indrekluuk/RobotexLineFollowerCamera/doc/IMG_1522.jpg

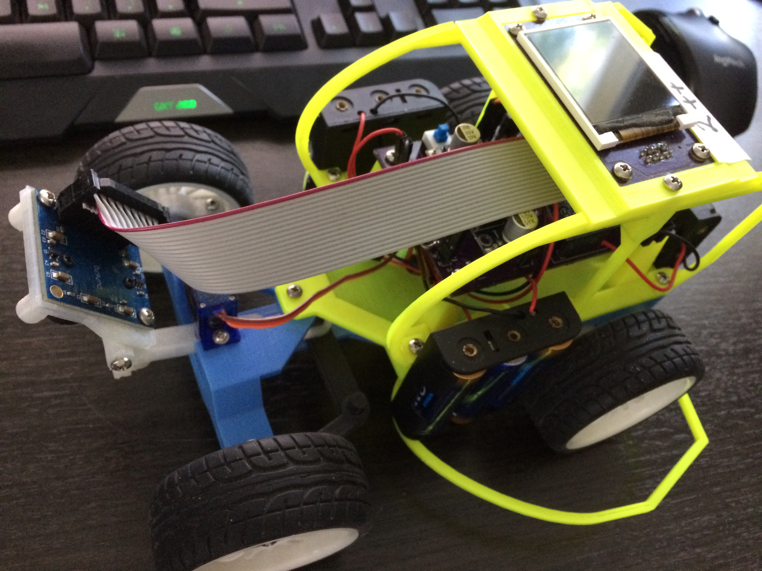
doc/IMG_1522.jpg
