indrekluuk/RobotexLineFollowerCamera/pcb/CameraBoard/Drill.png

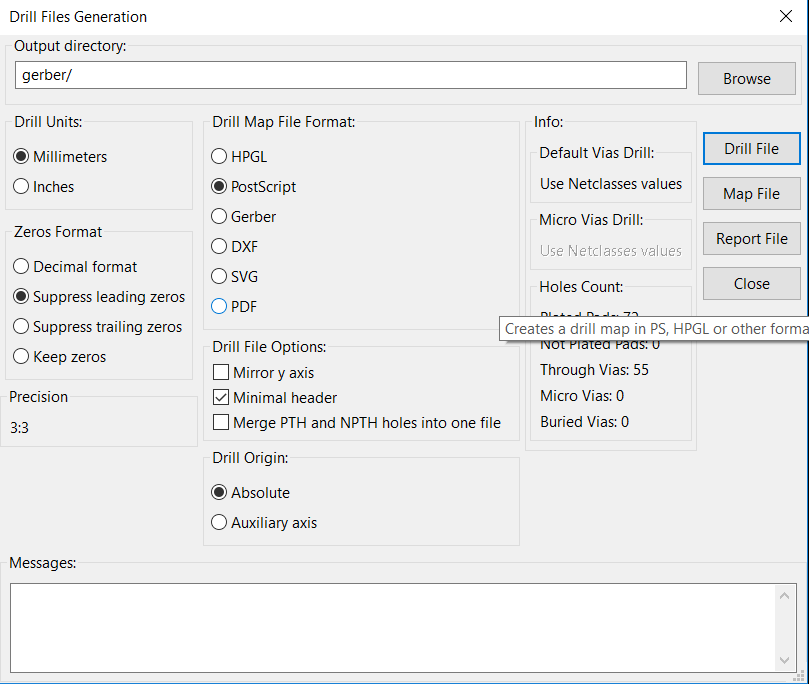
pcb/CameraBoard/Drill.png
