indrekluuk/RobotexLineFollowerCamera/pcb/CameraBoard/Plot.png

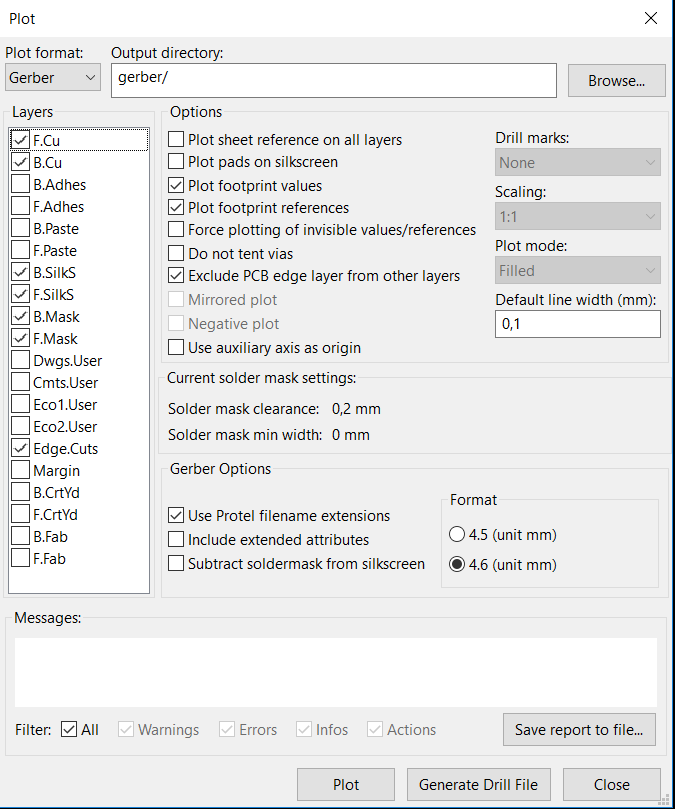
pcb/CameraBoard/Plot.png
