indrekluuk/RobotexLineFollowerCamera/pcb/CameraBoard/CameraBoard.kicad_pcb

## KiCad design pcb/CameraBoard/CameraBoard.kicad_pcb (2016-10-03)

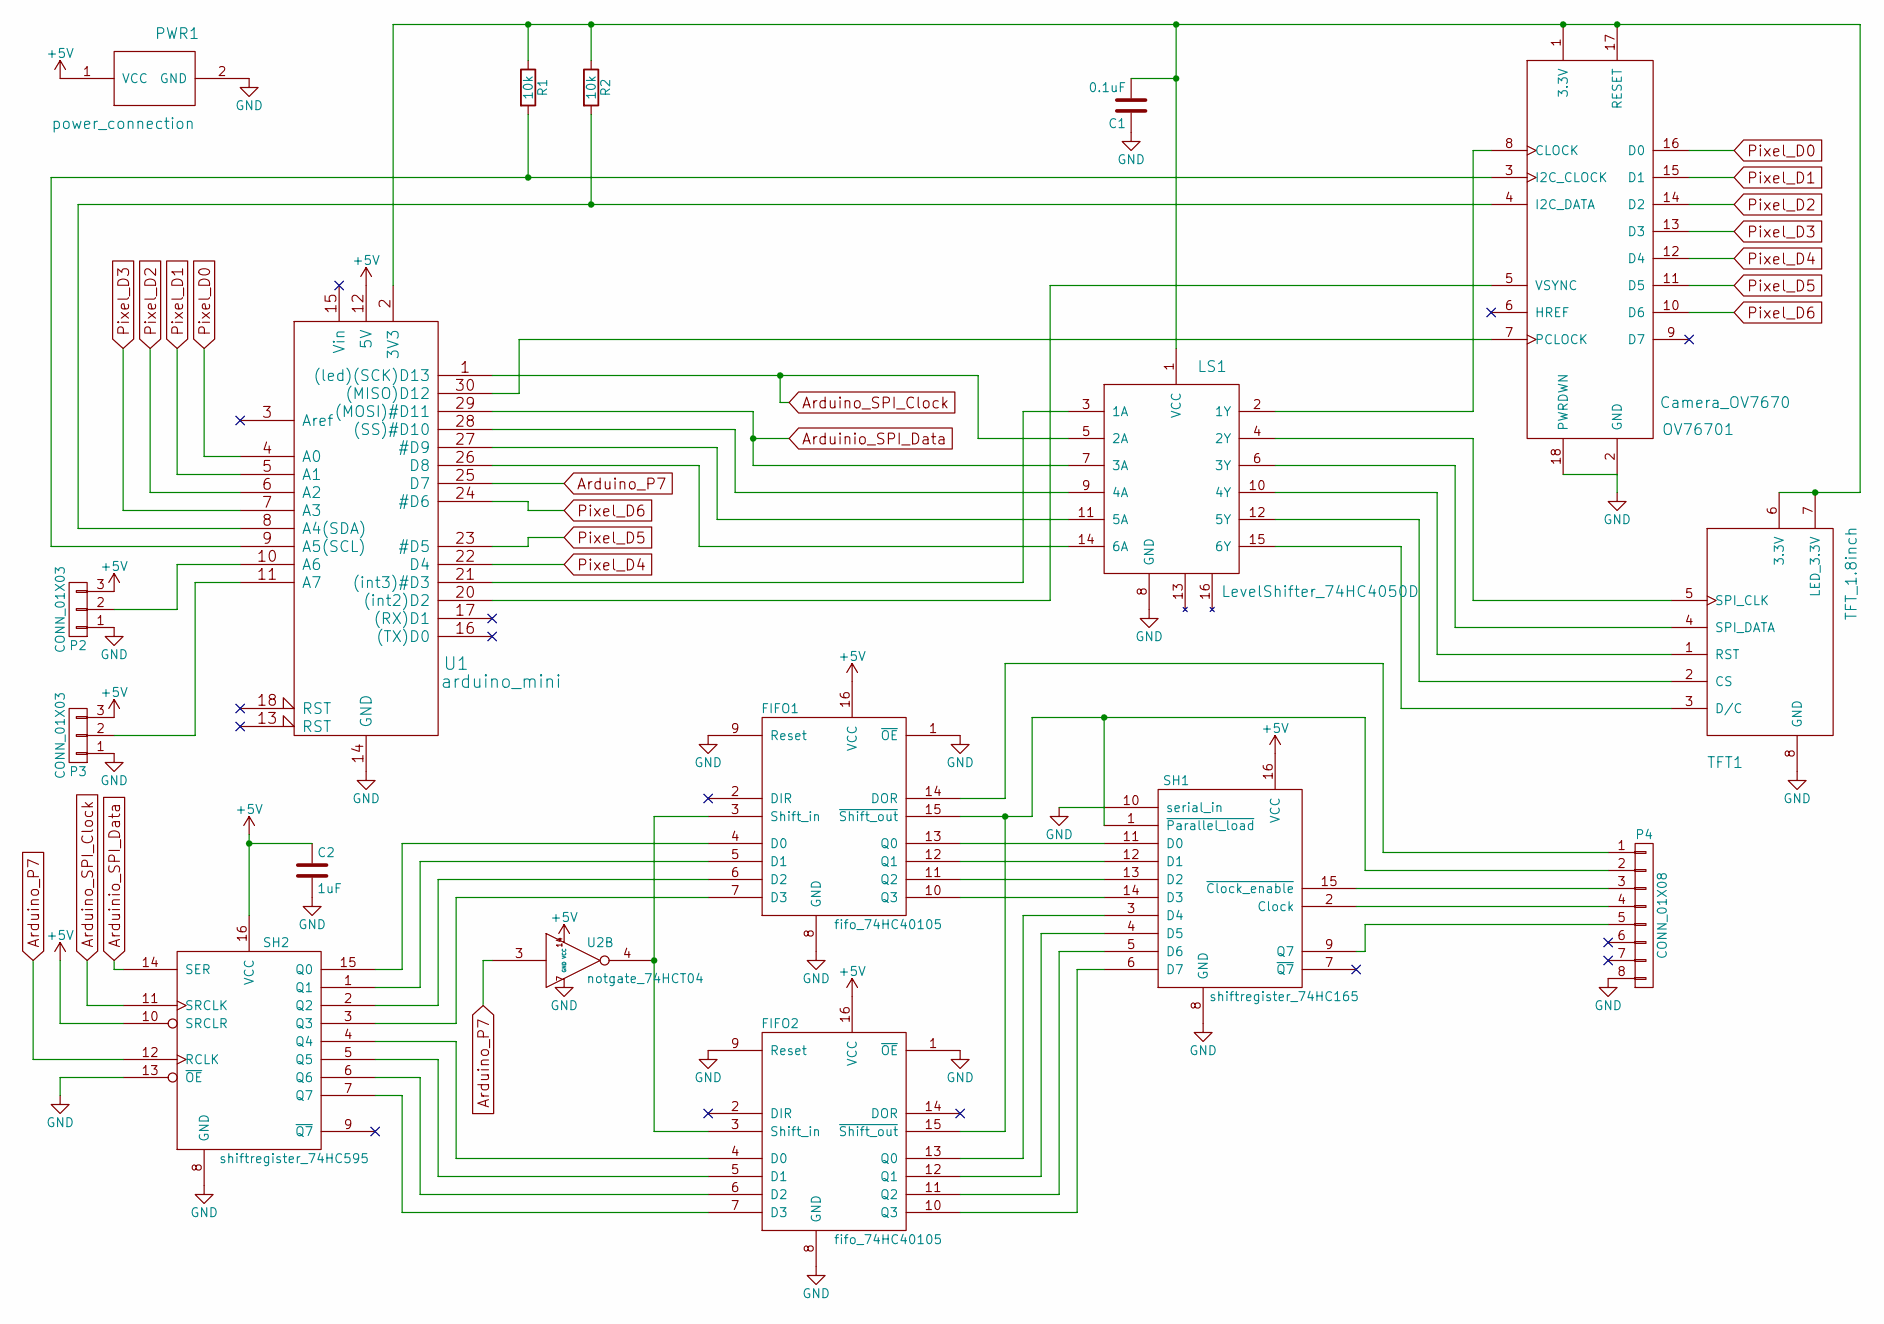
[picture p4: schematic CameraBoard.sch]

Parts:
C1: 0.1uF; C_1206_HandSoldering
C2: 1uF; C_1206_HandSoldering
FIFO1, FIFO2: fifo_74HC40105; SOIC-16_3.9x9.9mm_Pitch1.27mm
LS1: LevelShifter_74HC4050D; SOIC-16_3.9x9.9mm_Pitch1.27mm
OV76701: Camera_OV7670; Pin_Header_Straight_2x09
P2, P3: CONN_01X03; Pin_Header_Straight_1x03
P4: CONN_01X08; Pin_Header_Straight_2x04
PWR1: power_connection; Pin_Header_Straight_1x02
R1, R2: 10k; R_1206_HandSoldering
SH1: shiftregister_74HC165; SOIC-16_3.9x9.9mm_Pitch1.27mm
SH2: shiftregister_74HC595; SOIC-16_3.9x9.9mm_Pitch1.27mm
TFT1: TFT_1.8inch; Pin_Header_Straight_2x04
U1: arduino_mini
U2: notgate_74HCT04; SOIC-14_3.9x8.7mm_Pitch1.27mm

Connections:
+5V: C2.1, FIFO1.16 (VCC), FIFO2.16 (VCC), P2.3, P3.3, PWR1.1 (VCC), SH1.16 (VCC), SH2.10 (SRCLR), SH2.16 (VCC), U1.12 (5V), U2.14 (VCC)
Arduinio_SPI_Data: LS1.7 (3A), SH2.14 (SER), U1.29 ((MOSI)#D11)
Arduino_P7: SH2.12 (RCLK), U1.25 (D7), U2.3
Arduino_SPI_Clock: LS1.5 (2A), SH2.11 (SRCLK), U1.1 ((led)(SCK)D13)
GND: C1.1, C2.2, FIFO1.1 (~OE), FIFO1.8 (GND), FIFO1.9 (Reset), FIFO2.1 (~OE), FIFO2.8 (GND), FIFO2.9 (Reset), LS1.8 (GND), OV76701.2 (GND), OV76701.18 (PWRDWN), P2.1, P3.1, P4.8, PWR1.2 (GND), SH1.8 (GND), SH1.10 (serial_in), SH2.8 (GND), SH2.13 (~OE), TFT1.8 (GND), U1.14 (GND), U1.19 (GND), U2.7 (GND)
unnamed: C1.2, LS1.1 (VCC), OV76701.1 (3.3V), OV76701.17 (RESET), R1.1, R2.1, TFT1.6 (3.3V), TFT1.7 (LED_3.3V), U1.2 (3V3)
unnamed: FIFO1.3 (Shift_in), FIFO2.3 (Shift_in), U2.4
unnamed: FIFO1.4 (D0), SH2.15 (Q0)
unnamed: FIFO1.5 (D1), SH2.1 (Q1)
unnamed: FIFO1.6 (D2), SH2.2 (Q2)
unnamed: FIFO1.7 (D3), SH2.3 (Q3)
unnamed: FIFO1.10 (Q3), SH1.14 (D3)
unnamed: FIFO1.11 (Q2), SH1.13 (D2)
unnamed: FIFO1.12 (Q1), SH1.12 (D1)
unnamed: FIFO1.13 (Q0), SH1.11 (D0)
unnamed: FIFO1.14 (DOR), P4.1
unnamed: FIFO1.15 (~Shift_out), FIFO2.15 (~Shift_out), P4.2, SH1.1 (~Parallel_load)
unnamed: FIFO2.4 (D0), SH2.4 (Q4)
unnamed: FIFO2.5 (D1), SH2.5 (Q5)
unnamed: FIFO2.6 (D2), SH2.6 (Q6)
unnamed: FIFO2.7 (D3), SH2.7 (Q7)
unnamed: FIFO2.10 (Q3), SH1.6 (D7)
unnamed: FIFO2.11 (Q2), SH1.5 (D6)
unnamed: FIFO2.12 (Q1), SH1.4 (D5)
unnamed: FIFO2.13 (Q0), SH1.3 (D4)
unnamed: LS1.2 (1Y), OV76701.8 (CLOCK)
unnamed: LS1.3 (1A), U1.21 ((int3)#D3)
unnamed: LS1.4 (2Y), TFT1.5 (SPI_CLK)
unnamed: LS1.6 (3Y), TFT1.4 (SPI_DATA)
unnamed: LS1.9 (4A), U1.28 ((SS)#D10)
unnamed: LS1.10 (4Y), TFT1.1 (RST)
unnamed: LS1.11 (5A), U1.27 (#D9)
unnamed: LS1.12 (5Y), TFT1.2 (CS)
unnamed: LS1.14 (6A), U1.26 (D8)
unnamed: LS1.15 (6Y), TFT1.3 (D/C)
unnamed: OV76701.3 (I2C_CLOCK), R1.2, U1.9 (A5(SCL))
unnamed: OV76701.4 (I2C_DATA), R2.2, U1.8 (A4(SDA))
unnamed: OV76701.5 (VSYNC), U1.20 ((int2)D2)
unnamed: OV76701.7 (PCLOCK), U1.30 ((MISO)D12)
unnamed: P2.2, U1.10 (A6)
unnamed: P3.2, U1.11 (A7)
unnamed: P4.3, SH1.15 (~Clock_enable)
unnamed: P4.4, SH1.2 (Clock)
unnamed: P4.5, SH1.9 (Q7)
Pixel_D0: OV76701.16 (D0), U1.4 (A0)
Pixel_D1: OV76701.15 (D1), U1.5 (A1)
Pixel_D2: OV76701.14 (D2), U1.6 (A2)
Pixel_D3: OV76701.13 (D3), U1.7 (A3)
Pixel_D4: OV76701.12 (D4), U1.22 (D4)
Pixel_D5: OV76701.11 (D5), U1.23 (#D5)
Pixel_D6: OV76701.10 (D6), U1.24 (#D6)

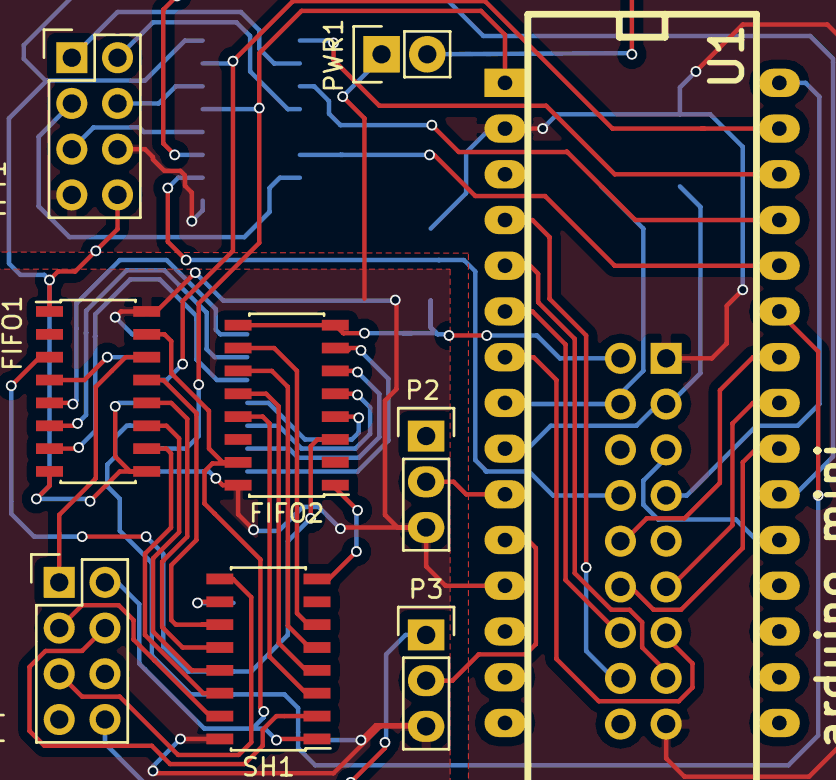
[picture p5: board CameraBoard.kicad_pcb from above]

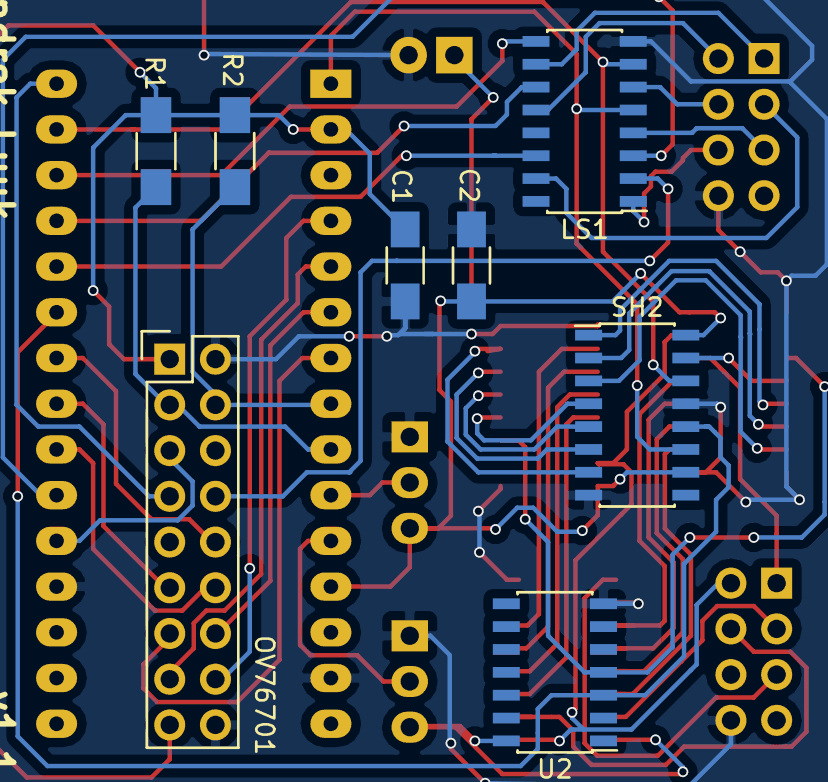
[picture p6: board CameraBoard.kicad_pcb from below]

Board: 2 copper layers, 17 parts (8 on the bottom side), 51 nets.
