indrekluuk/RobotexLineFollowerCamera/pcb/ScreenBoard/ScreenBoard.kicad_pcb

## KiCad design pcb/ScreenBoard/ScreenBoard.kicad_pcb (2016-07-10)

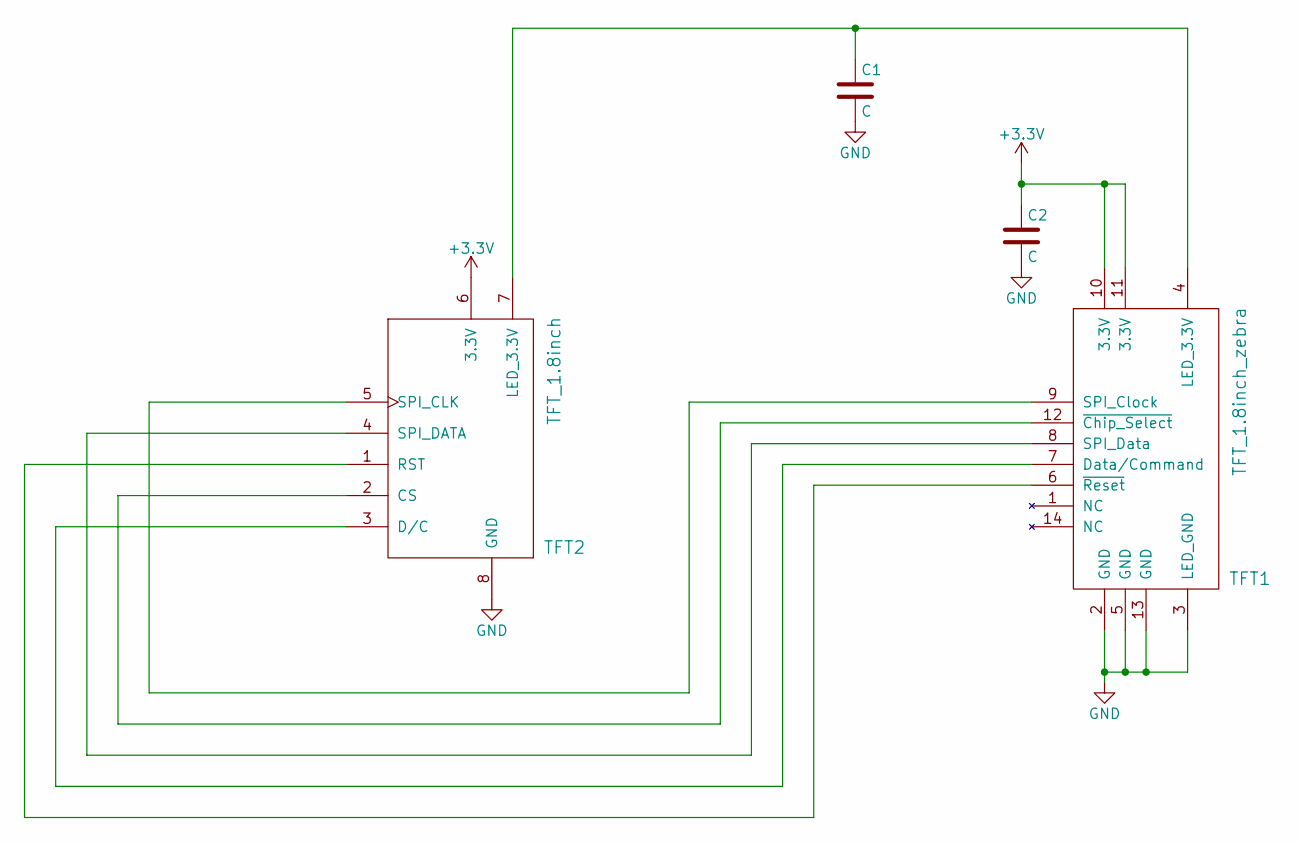
[picture p7: schematic ScreenBoard.sch]

Parts:
C1, C2: C; C_1206_HandSoldering
TFT1: TFT_1.8inch_zebra; ZebraStrip14_0.8mm
TFT2: TFT_1.8inch; Pin_Header_Straight_2x04

Connections:
+3V3: C2.1, TFT1.10 (3.3V), TFT1.11 (3.3V), TFT2.6 (3.3V)
GND: C1.2, C2.2, TFT1.2 (GND), TFT1.3 (LED_GND), TFT1.5 (GND), TFT1.13 (GND), TFT2.8 (GND)
unnamed: C1.1, TFT1.4 (LED_3.3V), TFT2.7 (LED_3.3V)
unnamed: TFT1.6 (~Reset), TFT2.1 (RST)
unnamed: TFT1.7 (Data/Command), TFT2.3 (D/C)
unnamed: TFT1.8 (SPI_Data), TFT2.4 (SPI_DATA)
unnamed: TFT1.9 (SPI_Clock), TFT2.5 (SPI_CLK)
unnamed: TFT1.12 (~Chip_Select), TFT2.2 (CS)

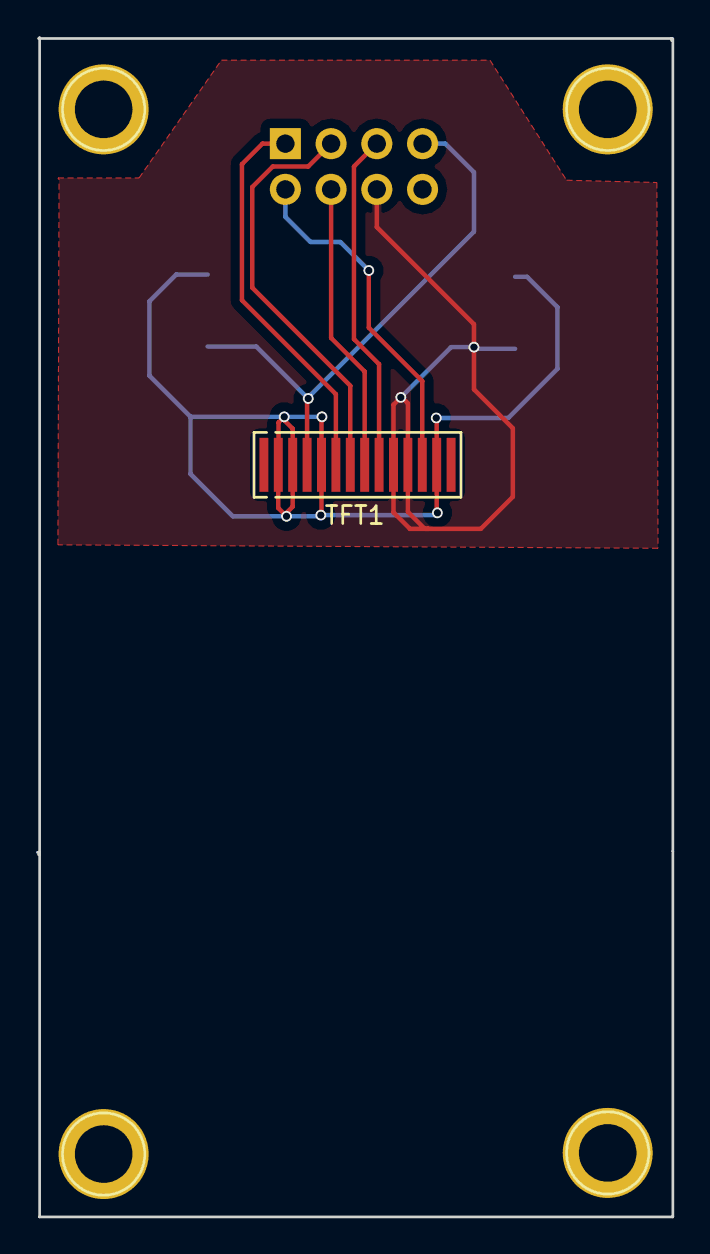
[picture p8: board ScreenBoard.kicad_pcb from above]

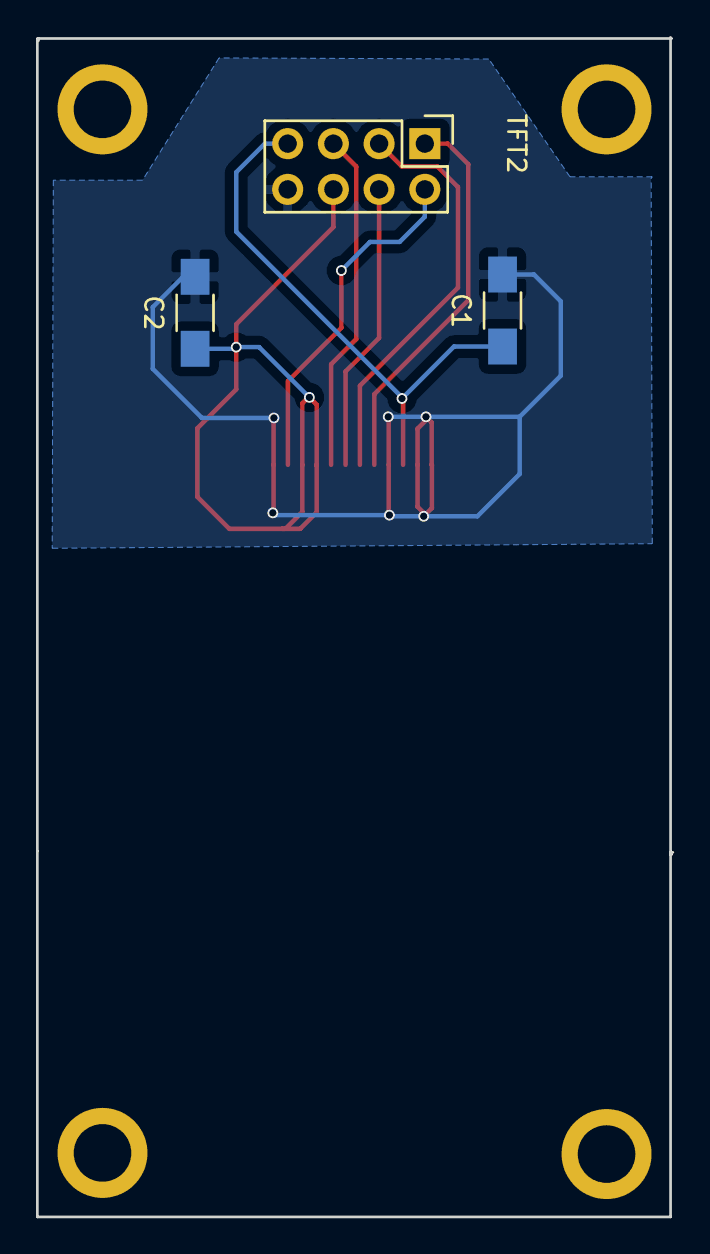
[picture p9: board ScreenBoard.kicad_pcb from below]

Board: 2 copper layers, 35.3 x 65.5 mm, 4 parts (3 on the bottom side), 8 nets.
