indrekluuk/RobotexLineFollowerCamera/arduino/src/line/LineSegment.cpp

//
// Created by indrek on 30.11.2016.
//

#include "LineSegment.h"




LineSegment::LineSegment() :
    start(lineNotFound),
    end(lineNotFound),
    center(lineNotFound),
    linePosition(lineNotFound)
{
}


LineSegment::LineSegment(int8_t start, int8_t end) :
    start(start),
    end(end),
    center((start + end) >> 1),
    linePosition(evaluateLinePosition())
{
}
