indrekluuk/RobotexLineFollowerCamera/arduino/src/line/RowBitmapLineSegmentFinder.cpp

//
// Created by indrek on 16.11.2016.
//

#include "RowBitmapLineSegmentFinder.h"


RowBitmapLineSegmentFinder::RowBitmapLineSegmentFinder() {

}



void RowBitmapLineSegmentFinder::reset() {
  currentRowIndex = -1;
  firstLineSegmentPreviousRow = LineSegment();
  secondLineSegmentPreviousRow = LineSegment();
}



void RowBitmapLineSegmentFinder::nextRow(uint8_t rowIndex, uint8_t bitmapHigh, uint8_t bitmapLow, LineSegment previousLineSegment) {
  firstLineSegment = previousLineSegment;
  nextRow(rowIndex, bitmapHigh, bitmapLow);
}



void RowBitmapLineSegmentFinder::nextRow(uint8_t rowIndex, uint8_t bitmapHigh, uint8_t bitmapLow) {
  currentRowIndex = rowIndex;
  firstLineSegmentPreviousRow = firstLineSegment;
  secondLineSegmentPreviousRow = secondLineSegment;
  firstLineSegment = LineSegment();
  secondLineSegment = LineSegment();

  int8_t segmentStart = LineSegment::lineNotFound;
  if (rowIndex >= ignoreRows) {
    processPixel(bitmapLow  & (uint8_t)0b00000001,  0, segmentStart);
    processPixel(bitmapLow  & (uint8_t)0b00000010,  2, segmentStart);
    processPixel(bitmapLow  & (uint8_t)0b00000100,  4, segmentStart);
    processPixel(bitmapLow  & (uint8_t)0b00001000,  6, segmentStart);
    processPixel(bitmapLow  & (uint8_t)0b00010000,  8, segmentStart);
    processPixel(bitmapLow  & (uint8_t)0b00100000, 10, segmentStart);
    processPixel(bitmapLow  & (uint8_t)0b01000000, 12, segmentStart);
    processPixel(bitmapLow  & (uint8_t)0b10000000, 14, segmentStart);
    processPixel(bitmapHigh & (uint8_t)0b00000001, 16, segmentStart);
    processPixel(bitmapHigh & (uint8_t)0b00000010, 18, segmentStart);
    processPixel(bitmapHigh & (uint8_t)0b00000100, 20, segmentStart);
    processPixel(bitmapHigh & (uint8_t)0b00001000, 22, segmentStart);
    processPixel(bitmapHigh & (uint8_t)0b00010000, 24, segmentStart);
    processPixel(bitmapHigh & (uint8_t)0b00100000, 26, segmentStart);
    processPixel(bitmapHigh & (uint8_t)0b01000000, 28, segmentStart);
    processPixel(bitmapHigh & (uint8_t)0b10000000, 30, segmentStart);

    if (segmentStart != LineSegment::lineNotFound) {
      processLineSegment(segmentStart, 30);
    }
  }
};
