indrekluuk/RobotexLineFollowerCamera/arduino/src/databuffer/DataBufferSender.cpp

//
// Created by indrek on 20.09.2016.
//

#include "DataBufferSender.h"
#include <SPI.h>


extern SPIClass SPI;
static SPISettings settings;

DataBufferSender::DataBufferSender() {
  settings = SPISettings(8000000, MSBFIRST, SPI_MODE0);
  pinMode(7, OUTPUT);
  PORTD = PORTD & (~PORTD_CLOCK_ENABLE_MAP);
}



void DataBufferSender::sendMessage(uint8_t commandCode, uint8_t * buf, uint8_t count) {
  sendByte(MESSAGE_START | (commandCode & MESSAGE_COMMAND_MASK) | (count & MESSAGE_COUNT_MASK));
  uint8_t * bufEnd = buf + count;
  for (; buf < bufEnd; buf++) {
    sendByte((*buf) & MESSAGE_DATA_MASK);
  }
}


void DataBufferSender::dataDelay() {
  asm volatile("nop");
  asm volatile("nop");
  asm volatile("nop");
  asm volatile("nop");
  asm volatile("nop");
  asm volatile("nop");
}
