indrekluuk/RobotexLineFollowerCamera/arduino/src/MonochromeBufferMask.h

//
// Created by indrek on 12.11.2016.
//

#ifndef ROBOTEXLINEFOLLOWERCAMERA_MONOCHROMEBUFFERMASK_H
#define ROBOTEXLINEFOLLOWERCAMERA_MONOCHROMEBUFFERMASK_H


const uint8_t monochromeBufferMask[80] = {
    0x01	,
    0x01	,
    0x01	,
    0x01	,
    0x01	,
    0x02	,
    0x02	,
    0x02	,
    0x02	,
    0x02	,
    0x04	,
    0x04	,
    0x04	,
    0x04	,
    0x04	,
    0x08	,
    0x08	,
    0x08	,
    0x08	,
    0x08	,
    0x10	,
    0x10	,
    0x10	,
    0x10	,
    0x10	,
    0x20	,
    0x20	,
    0x20	,
    0x20	,
    0x20	,
    0x40	,
    0x40	,
    0x40	,
    0x40	,
    0x40	,
    0x80	,
    0x80	,
    0x80	,
    0x80	,
    0x80	,
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
};


#endif //ROBOTEXLINEFOLLOWERCAMERA_MONOCHROMEBUFFERMASK_H
