indrekluuk/RobotexLineFollowerCamera/arduino/src/ByteInversionTable.h

//
// Created by indrek on 30.04.2016.
//

#ifndef ROBOTEXLINEFOLLOWERCAMERA_BYTEINVERSIONTABLE_H
#define ROBOTEXLINEFOLLOWERCAMERA_BYTEINVERSIONTABLE_H


// grayscale table for inverted byte
// 00000000, 10000000, 01000000, 11000000, 00100000 ...

const uint8_t byteInversionTable[] = {
    0,
    128,
    64,
    192,
    32,
    160,
    96,
    224,
    16,
    144,
    80,
    208,
    48,
    176,
    112,
    240,
    8,
    136,
    72,
    200,
    40,
    168,
    104,
    232,
    24,
    152,
    88,
    216,
    56,
    184,
    120,
    248,
    4,
    132,
    68,
    196,
    36,
    164,
    100,
    228,
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
};



#endif //ROBOTEXLINEFOLLOWERCAMERA_BYTEINVERSIONTABLE_H
