indrekluuk/RobotexLineFollowerCamera/(commit log)

2016-04-26 added RGB greyscale table
    [greyscale_table.ods]
2016-04-30 camera code separated to its own file
2016-04-30 5Hz with loop
2016-04-30 unified class for below 10hz
2016-04-30 wait for 5Hz
2016-05-07 updated camera library
2016-05-11 method for reversing bits
    [CameraOV7670.cpp]
2016-05-13 added PCB - in progress
    [CameraBoard.kicad_pcb, CameraBoard.sch]
2016-05-15 PCB with FIFO
    [CameraBoard.sch]
2016-05-15 PCB footprints are not set
    [CameraBoard.sch]
2016-05-15 PCB fully wired
    [CameraBoard.sch]
2016-05-16 generated gerber files
    [CameraBoard-B.Cu.gbl, CameraBoard-B.Mask.gbs, CameraBoard-B.SilkS.gbo, CameraBoard-Edge.Cuts.gm1, CameraBoard-F.Cu.gtl, CameraBoard-F.Mask.gts, CameraBoard-F.SilkS.gto, CameraBoard.drl]
2016-06-11 Fixed NOT gate footprint
    [CameraBoard-B.Cu.gbl, CameraBoard-B.Mask.gbs, CameraBoard-B.SilkS.gbo, CameraBoard-Edge.Cuts.gm1, CameraBoard-F.Cu.gtl, CameraBoard-F.Mask.gts, CameraBoard-F.SilkS.gto, CameraBoard.drl]
2016-07-10 moved camera board pcb to sub-folder
    [CameraBoard-B.Cu.gbl, CameraBoard-B.Mask.gbs, CameraBoard-B.SilkS.gbo, CameraBoard-Edge.Cuts.gm1, CameraBoard-F.Cu.gtl, CameraBoard-F.Mask.gts, CameraBoard-F.SilkS.gto, CameraBoard.drl]
2016-07-10 added screen board
    [ScreenBoard-B.Cu.gbr, ScreenBoard-B.Mask.gbr, ScreenBoard-B.SilkS.gbr, ScreenBoard-Edge.Cuts.gbr, ScreenBoard-F.Cu.gbr, ScreenBoard-F.Mask.gbr, ScreenBoard-F.SilkS.gbr, ScreenBoard.drl]
2016-07-10 removed labels from screw holes
    [ScreenBoard.kicad_pcb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]
2016-09-07 code is now working with new camera board
    [greyscale_table.ods]
2016-10-02 send data to shift register
    [CameraBoard.sch]
2016-10-03 fixed PCB
    [CameraBoard.kicad_pcb]
2016-10-30 init all camera related items at one place
2016-11-06 camera library update
2016-11-07 new buffered camera for 80x120 grayscale
2016-11-12 14 bit monochrome buffer
    [monochrome_buffer_index.ods]
2016-11-12 shifted lower byte by one
    [monochrome_buffer_index.ods]
2016-11-13 optimized screen cycles
    [monochrome_buffer_index.ods]
2016-11-16 line detection working
    [monochrome_buffer_index.ods]
2016-11-20 fixed row detection if no row from the start of the screen
    [Line.h]
2016-11-20 fixed line if segments didn't touch
    [Line.h]
2016-11-20 fixed start looking for line at the mid-point
    [Line.h]
2016-11-24 spreadsheet for slope calculation
    [Slope_calc.ods]
2016-11-25 print calculated slope value
2016-11-25 fixed bottom slope calculation
    [Line.h]
2016-11-25 adjusted slope delta
    [Slope_calc.ods]
2016-11-25 test case 3
2016-11-25 test case 4
2016-11-25 test case 5 (failing)
2016-11-26 fixed line edge reset
    [LineEdge.h]
2016-11-26 fixed first step position value
    [LineEdge.h, RowLinePosition.h]
2016-11-26 frame capture printout directly in camera Arduino
2016-11-27 do not start line if it is detected from bottom corners (camera can see the wheel)
2016-11-29 fixed sharp turn direction
    [Line.h]
2016-11-30 failing test for line split
    [main.cpp]
2016-12-01 fixed end of line
    [Line.h]
2016-12-01 improved split line printout
2016-12-02 moved line turn ignore check to more correct location
    [Line.h, LineEdge.h]
2016-12-02 fixed line detection if line takes whole screen
    [Line.h, LineSegment.cpp, LineSegment.h, RowBitmapLineSegmentFinder.cpp, RowBitmapLineSegmentFinder.h]
